sophieannel/bankerproject/README.md

# bankerproject
A device able to recognize the value of Canadian banknotes based on their color, count them, and display the total with automatized insertion and display
