sophieannel/bankerproject/The Banker Project.pdf

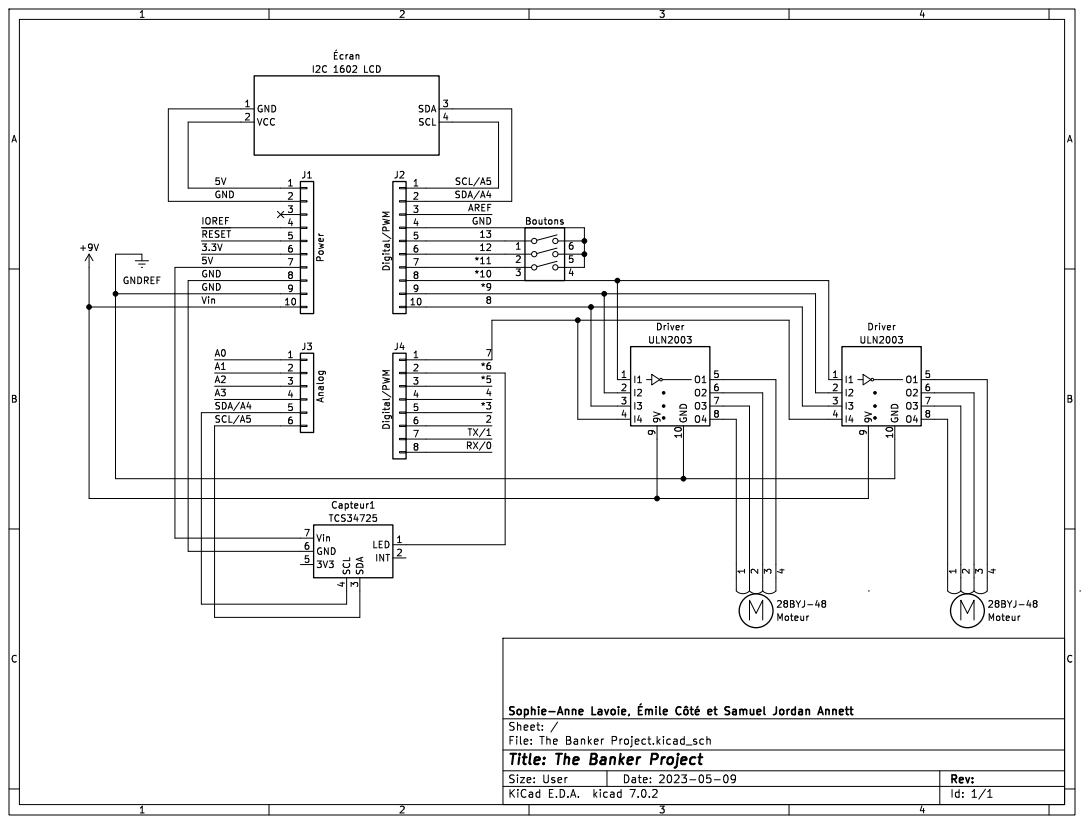
[picture p7: page 1]
